Bangura30/USB_PD_CH224A/outputs/pcb.pdf

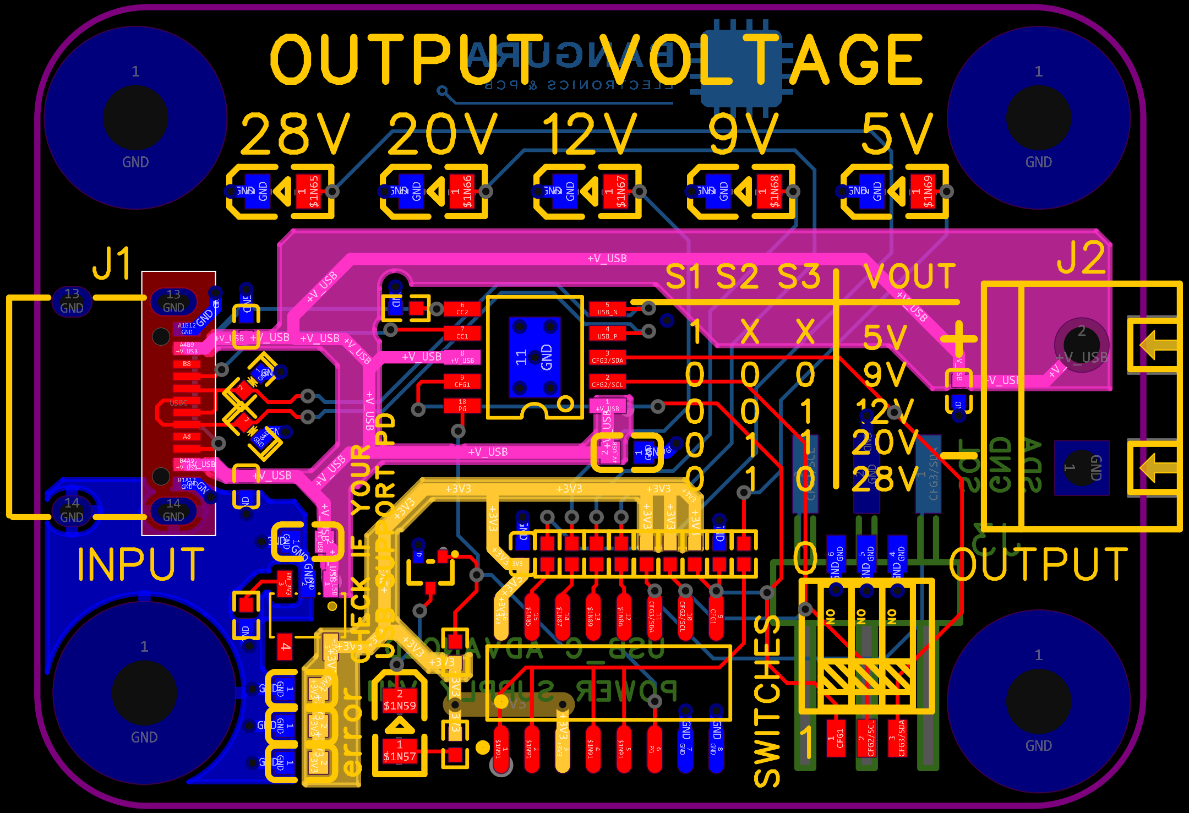
[picture p4: page 1]
