Bangura30/USB_PD_CH224A/outputs/bom.xlsx

No. | Quantity | Comment | Designator | Footprint | Value | Manufacturer Part | Manufacturer | Supplier Part | Supplier
1 | 4 | 100nF | C1,C2,C3,C5 | C0402 | 100nF | CL05B104KB54PNC | SAMSUNG(三星) | C307331 | LCSC
2 | 5 | 1uF | C4,C6,C7,C8,C9 | C0603 | 1uF | CL10B105KB9VPJC | SAMSUNG(三星) | C38968597 | LCSC
3 | 2 | GG0402050R3C2P | D1,D2 | D0402-BI |  | GG0402050R3C2P | Kyocera AVX | C2649889 | LCSC
4 | 1 | TYPE-C 16PIN 2MD(073) | J1 | USB-C-SMD_TYPE-C-16PIN-2MD-073 |  | TYPE-C 16PIN 2MD(073) | SHOU HAN(首韩) | C2765186 | LCSC
5 | 1 | MKDSN 1,5/ 2-5,08 | J2 | CONN-TH_2P-P5.08_1729128 |  | MKDSN 1,5/ 2-5,08 | Phoenix Contact(菲尼克斯) | C5183989 | LCSC
6 | 1 | KT-0805R | LED1 | LED0805-R-RD |  | KT-0805R | KENTO | C2295 | LCSC
7 | 5 | KT-0805G | LED2,LED3,LED4,LED5,LED6 | LED0805-R-RD |  | KT-0805G | KENTO | C2297 | LCSC
8 | 1 | 2N7002T-7-F | Q1 | SOT-523-3_L1.6-W0.8-P1.00-LS1.6-BR |  | 2N7002T-7-F | DIODES(美台) | C139445 | LCSC
9 | 6 | 1kΩ | R1,R8,R10,R11,R12,R13 | R0402 | 1kΩ | 0402WGF1001TCE | UNI-ROYAL(厚声) | C11702 | LCSC
10 | 4 | 10kΩ | R2,R3,R4,R5 | R0402 | 10kΩ | HQ02WAF1002TCE | UNI-ROYAL(厚声) | C2791317 | LCSC
11 | 1 | BX-DS1.27-3PTP | SW1 | SW-SMD_6P-P1.27_BX-DS1.27-3PTP |  | BX-DS1.27-3PTP | Bossie(博锡) | C18078238 | LCSC
12 | 1 | CH224A | U1 | ESSOP-10_L4.9-W3.9-P1.0-LS6.0-TL-EP |  | CH224A | WCH(南京沁恒) | C42459160 | LCSC
13 | 1 | TPS70933DBVR | U2 | SOT-23-5_L3.0-W1.7-P0.95-LS2.8-BR |  | TPS70933DBVR | TI(德州仪器) | C89347 | LCSC
14 | 1 | MC14051BDR2G | U3 | SOIC-16_L9.9-W3.9-P1.27-LS6.0-BL |  | MC14051BDR2G | onsemi(安森美) | C7284 | LCSC
