Bangura30/USB_PD_CH224A/CH224A-USB-PD-Board.step

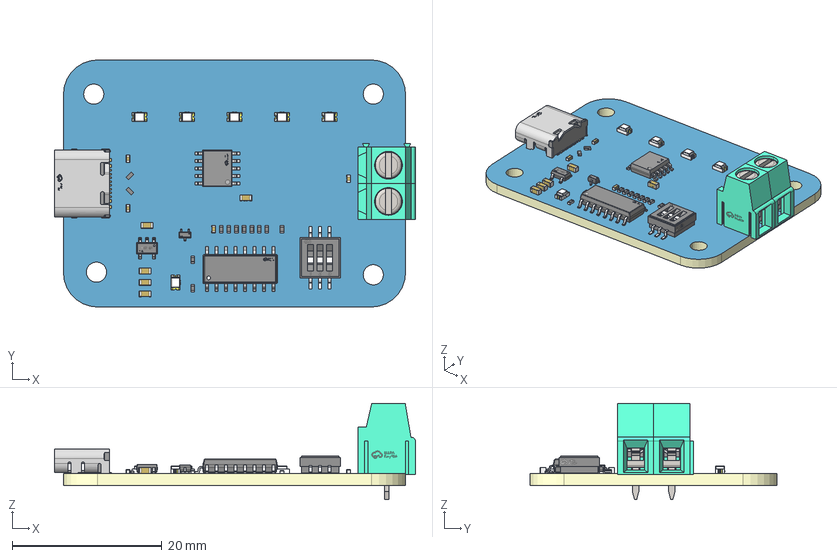
[picture p5: CAD file, 2026-10-19]
CH224A-USB-PD-Board.step
48.2 x 33.0 x 12.9 mm
Board~aqOk
TopCopper~aqOk
BottomCopper~aqOk
TopSilkscreen~aqOk
BottomSilkscreen~aqOk
TopFpcStiffener~aqOk
BottomFpcStiffener~aqOk
C0603~C0603_L1.6-W0.8-H0.8~feK0 x 5
C0402~C0402_L1.0-W0.5-H0.5~rOdd x 4
D0402-BI~D0402_L1.0-W0.5-H0.5~e3si x 2
R0402~R0402_L1.0-W0.5-H0.4~slSQ x 10
USB-C-SMD_TYPE-C-16PIN-2MD-073~USB-C-SMD_TYPE-C-6PIN-2MD-073~QoP8
CONN-TH_2P-P5.08_1729128~CONN-TH_2P-P5.08_1729128~ewbO
SOT-23-5_L3.0-W1.7-P0.95-LS2.8-BR~SOT-23-5_L2.9-W1.6-H1.1-LS2.8-P0.95~xf7b
ESSOP-10_L4.9-W3.9-P1.0-LS6.0-TL-EP~ESSOP-10_L4.9-W3.9-P1.0-LS6.0-TL-EP~j7AQ
LED0805-R-RD~LED0805-RD~sgRL x 6
SW-SMD_6P-P1.27_BX-DS1.27-3PTP~SW-SMD_6P-P1.27_BX-DS1.27-3PTP~dBg5
SOIC-16_L9.9-W3.9-P1.27-LS6.0-BL~SOIC-16_L9.9-W3.9-H1.8-LS6.0-P1.27~rgxF
SOT-523-3_L1.6-W0.8-P1.00-LS1.6-BR~SOT-523-3P_L1.6-W0.8-H0.9-LS1.6-P0.50~weMI
