Bangura30/USB_PD_CH224A/outputs/schematic.pdf

# USB PD Controller

# USB_C ADVANCED POWER SUPPLY 5/10/12/20/28V

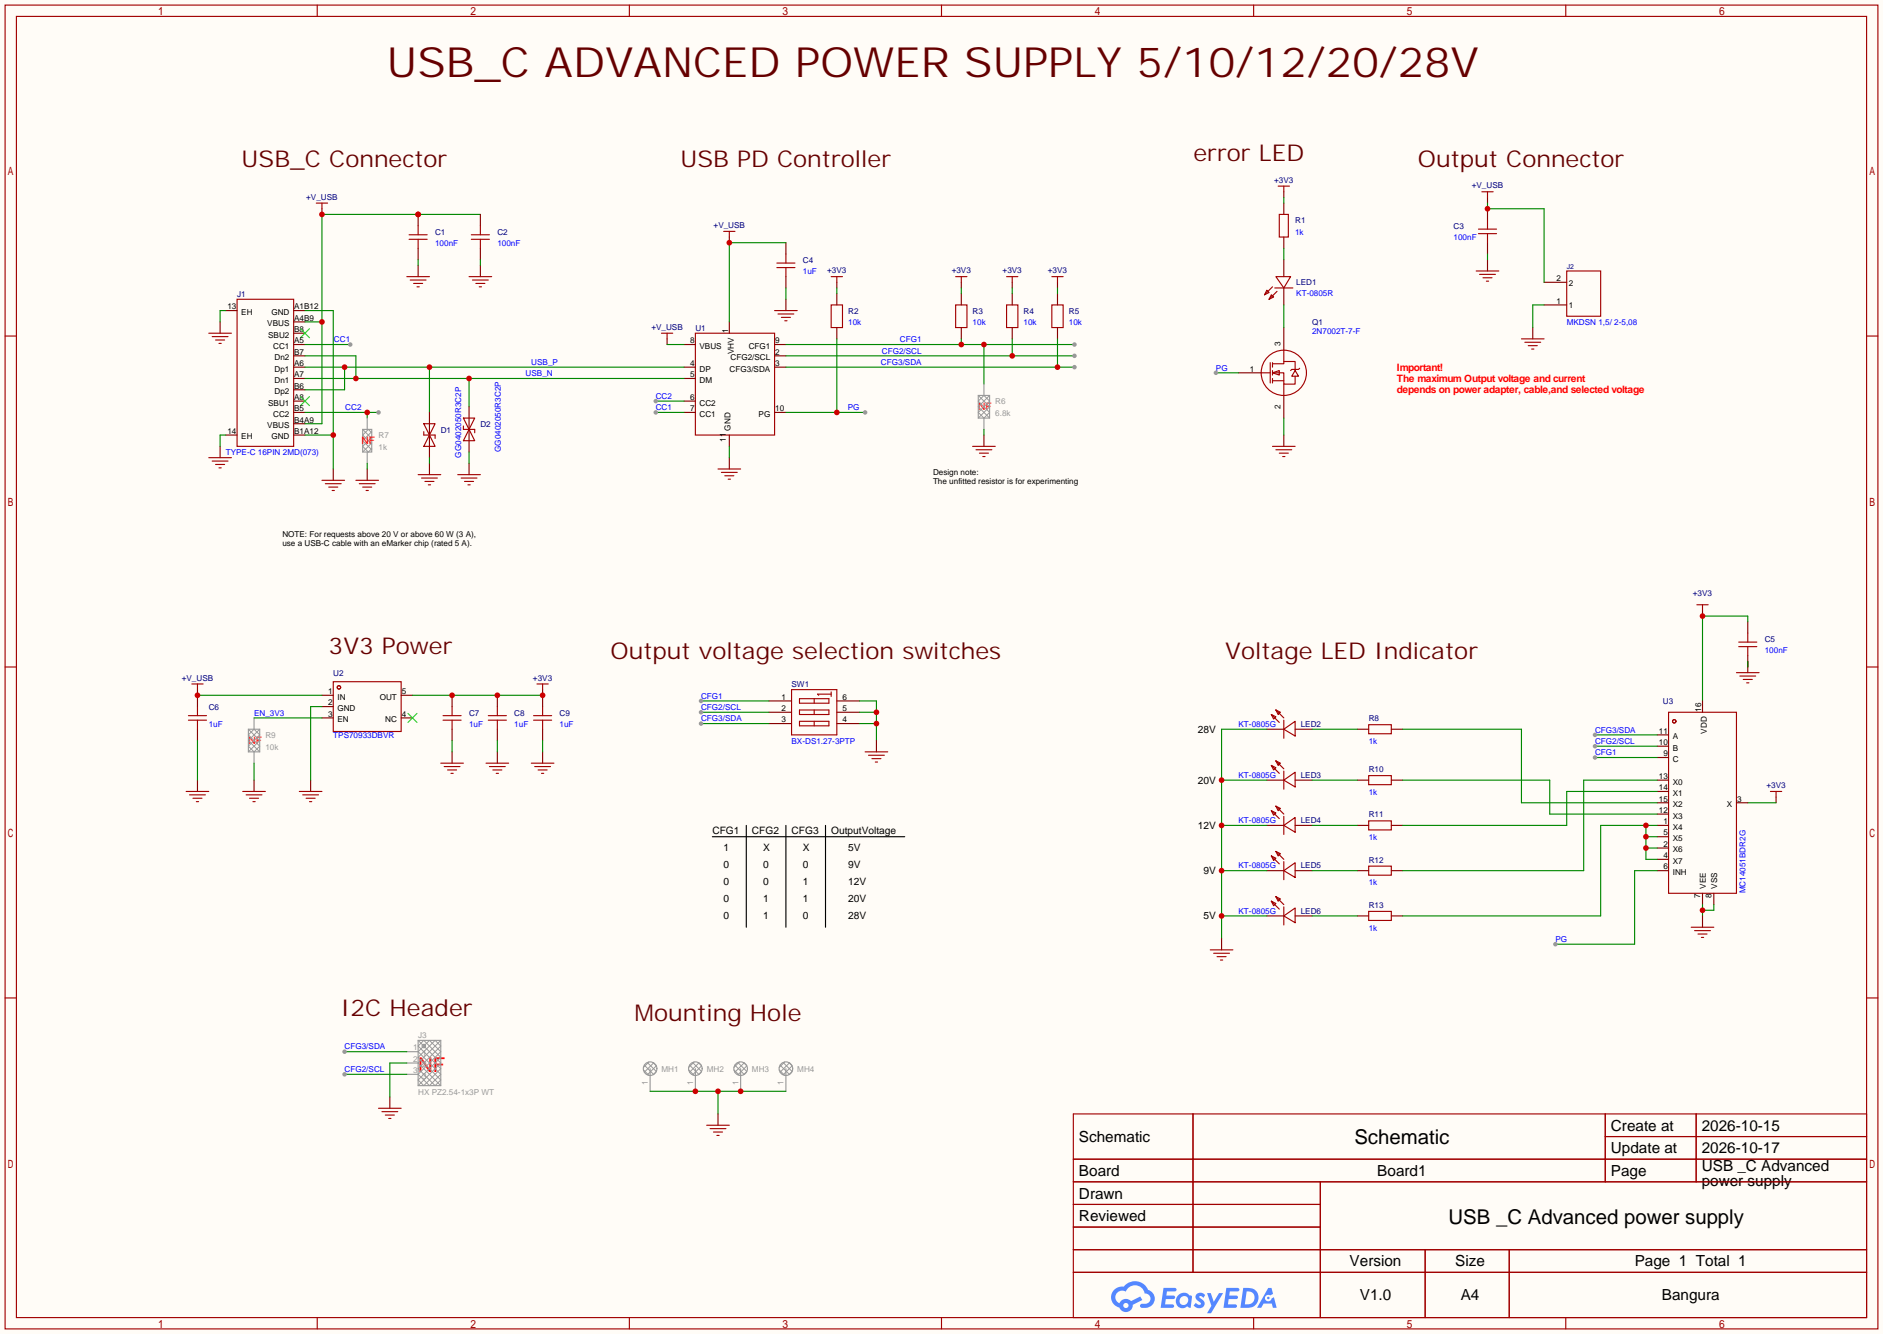
[picture p6: page 1]

Important!
The maximum Output voltage and current
depends on power adapter, cable,and selected voltage

Design note:
The unfitted resistor is for experimenting

NOTE: For requests above 20 V or above 60 W (3 A),
use a USB-C cable with an eMarker chip (rated 5 A).

Schematic | Schematic | Create at | 2026-10-15

Update at | 2026-10-17

Board | Board1 | Page | USB _C Advanced
Drawn | | USB _C Advanced power supply
Reviewed

Version | Size | Page 1 Total 1
V1.0 | A4 | Bangura
